owenosborn/CM3-Basic-PCB/README.md

# CM3-Basic-PCB

A basic PCB layout for the Raspberry Pi Compute Module 3 in Eagle.

Uses most of the same parts as the CMIO board.
