owenosborn/CM3-Basic-PCB/cm3_basic.brd

## EAGLE design cm3_basic.brd (2018-09-14)

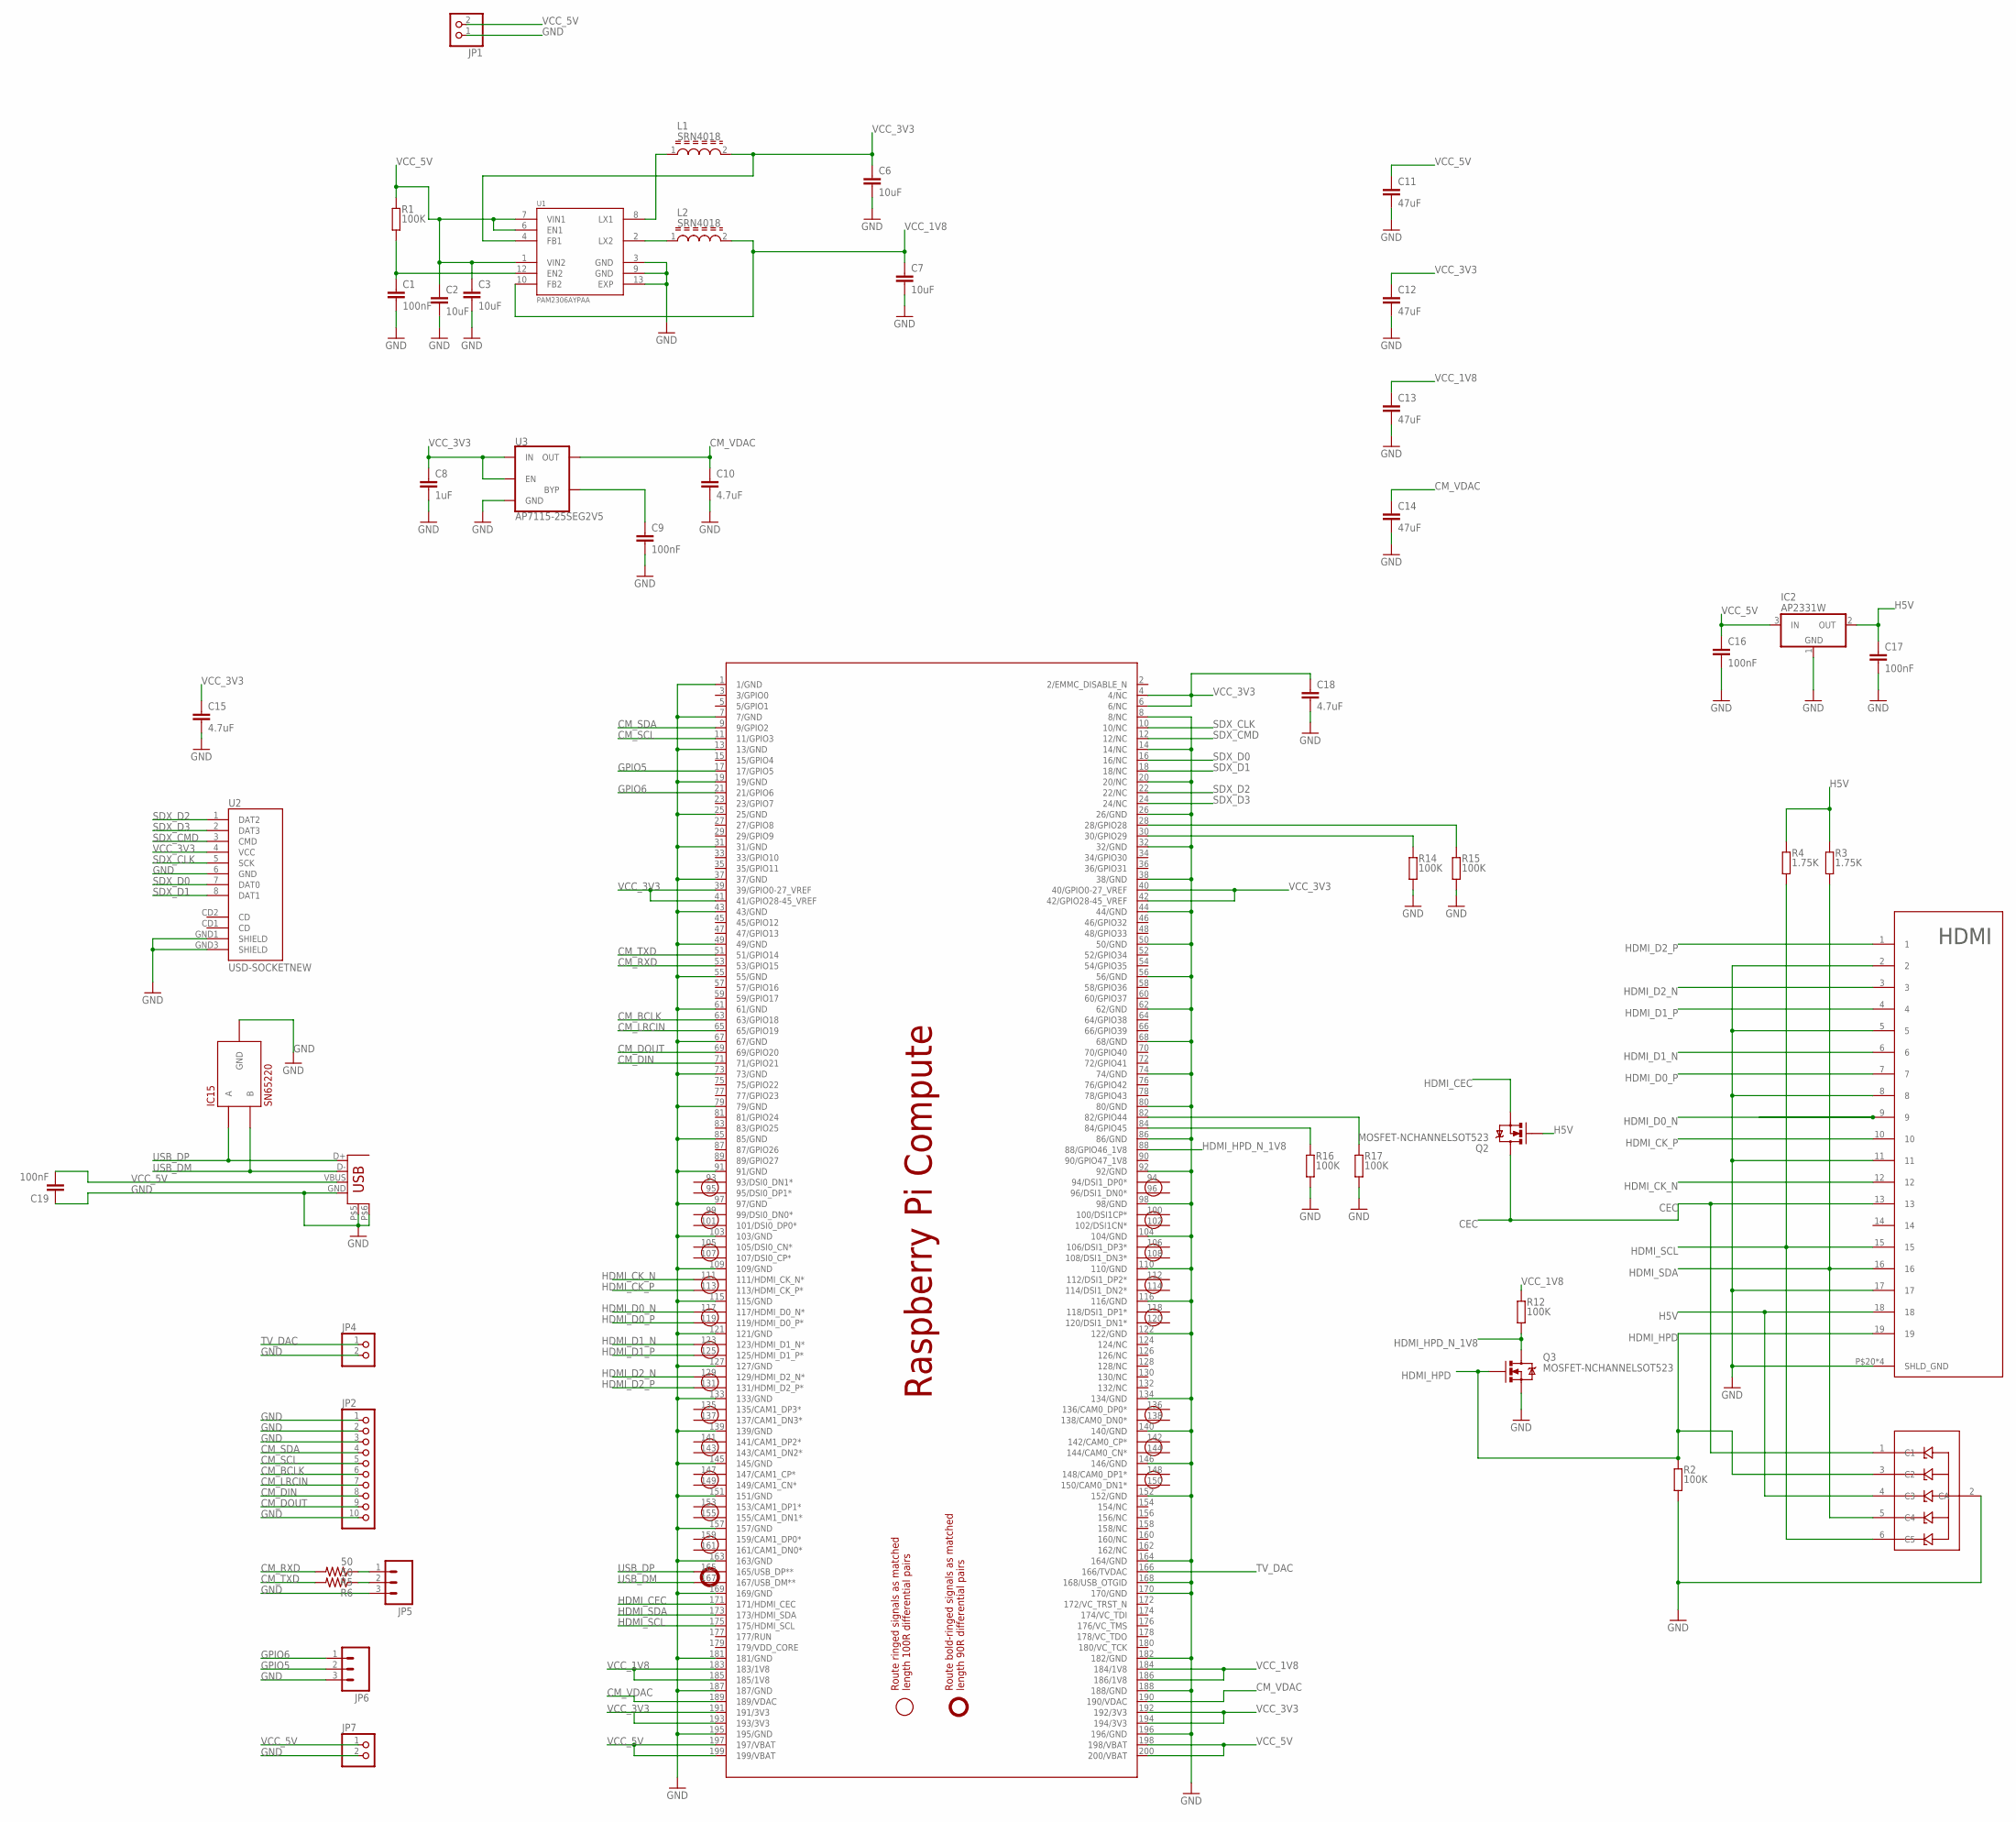
[picture p1: schematic cm3_basic.sch]

Parts:
C1, C9, C16, C17: 100nF; C0603
C2, C3, C6, C7: 10uF; C0805
C8: 1uF; C0603
C10, C15: 4.7uF; C0603
C11, C12, C13, C14: 47uF; C3216
C18: 4.7uF; C1608
C19: 100nF; 0603-CAP
IC1: PESD3V3L5UYSOT363; SOT363-INFINION
IC2: AP2331W; SOT23
IC15: SN65220; SOT23-6L
JP1, JP4, JP7: PINHD-1X2; 1X02
JP2: PINHD-1X10; 1X10
JP3: USB-A; USB-A-S-NOSILK-FEMALE
JP5, JP6: M03LOCK_LONGPADS; 1X03_LOCK_LONGPADS
L1, L2: SRN4018; INDP4040X180N
Q2, Q3: MOSFET-NCHANNELSOT523; SOT523
R1, R2, R12, R14, R15, R16, R17: 100K; R0603
R3, R4: 1.75K; R0603
R5, R6: 50; 0603-RES
SODIMM: RPI_COMPUTE
U1: PAM2306AYPAA; SON45P300X300X80-13N
U2: USD-SOCKETNEW; MICRO-SD-SOCKET-PP
U3: AP7115-25SEG2V5; SC70
U4: HDMI

Connections:
CEC: IC1.1 (C1), Q2.3 (D), U4.13
CM_BCLK: JP2.6, SODIMM.63 (63/GPIO18)
CM_DIN: JP2.8, SODIMM.71 (71/GPIO21)
CM_DOUT: JP2.9, SODIMM.69 (69/GPIO20)
CM_LRCIN: JP2.7, SODIMM.65 (65/GPIO19)
CM_RXD: R5.2, SODIMM.53 (53/GPIO15)
CM_SCL: JP2.5, SODIMM.11 (11/GPIO3)
CM_SDA: JP2.4, SODIMM.9 (9/GPIO2)
CM_TXD: R6.2, SODIMM.51 (51/GPIO14)
CM_VDAC: C10.1, C14.1, SODIMM.189 (189/VDAC), SODIMM.190 (190/VDAC), U3.5 (OUT)
GND: C1.2, C2.2, C3.2, C6.2, C7.2, C8.2, C9.2, C10.2, C11.2, C12.2, C13.2, C14.2, C15.2, C16.2, C17.2, C18.2, C19.1, IC1.2 (CA), IC2.1 (GND), IC15.2 (GND), IC15.5 (GND), JP1.1, JP2.1, JP2.2, JP2.3, JP2.10, JP3.GND, JP3.P$5 (SHIELD1), JP3.P$6 (SHIELD2), JP4.2, JP5.3, JP6.3, JP7.2, Q3.2 (S), R2.1, R14.1, R15.1, R16.1, R17.1, SODIMM.1 (1/GND), SODIMM.7 (7/GND), SODIMM.8 (8/NC), SODIMM.13 (13/GND), SODIMM.14 (14/NC), SODIMM.19 (19/GND), SODIMM.20 (20/NC), SODIMM.25 (25/GND), SODIMM.26 (26/GND), SODIMM.31 (31/GND), SODIMM.32 (32/GND), SODIMM.37 (37/GND), SODIMM.38 (38/GND), SODIMM.43 (43/GND), SODIMM.44 (44/GND), SODIMM.49 (49/GND), SODIMM.50 (50/GND), SODIMM.55 (55/GND), SODIMM.56 (56/GND), SODIMM.61 (61/GND), SODIMM.62 (62/GND), SODIMM.67 (67/GND), SODIMM.68 (68/GND), SODIMM.73 (73/GND), SODIMM.74 (74/GND), SODIMM.79 (79/GND), SODIMM.80 (80/GND), SODIMM.85 (85/GND), SODIMM.86 (86/GND), SODIMM.91 (91/GND), SODIMM.92 (92/GND), SODIMM.97 (97/GND), SODIMM.98 (98/GND), SODIMM.103 (103/GND), SODIMM.104 (104/GND), SODIMM.109 (109/GND), SODIMM.110 (110/GND), SODIMM.115 (115/GND), SODIMM.116 (116/GND), SODIMM.121 (121/GND), SODIMM.122 (122/GND), SODIMM.127 (127/GND), SODIMM.133 (133/GND), SODIMM.134 (134/GND), SODIMM.139 (139/GND), SODIMM.140 (140/GND), SODIMM.145 (145/GND), SODIMM.146 (146/GND), SODIMM.151 (151/GND), SODIMM.152 (152/GND), SODIMM.157 (157/GND), SODIMM.163 (163/GND), SODIMM.164 (164/GND), SODIMM.168 (168/USB_OTGID), SODIMM.169 (169/GND), SODIMM.170 (170/GND), SODIMM.181 (181/GND), SODIMM.182 (182/GND), SODIMM.187 (187/GND), SODIMM.188 (188/GND), SODIMM.195 (195/GND), SODIMM.196 (196/GND), U1.3 (GND), U1.9 (GND), U1.13 (EXP), U2.6 (GND), U2.GND1 (SHIELD), U2.GND3 (SHIELD), U3.2 (GND), U4.2, U4.5, U4.8, U4.11, U4.17, U4.P$20 (SHLD_GND), U4.P$21 (SHLD_GND), U4.P$22 (SHLD_GND), U4.P$23 (SHLD_GND)
GPIO5: JP6.2, SODIMM.17 (17/GPIO5)
GPIO6: JP6.1, SODIMM.21 (21/GPIO6)
H5V: C17.1, IC1.4 (C3), IC2.2 (OUT), Q2.1 (G), R3.2, R4.2, U4.18
HDMI_CEC: Q2.2 (S), SODIMM.171 (171/HDMI_CEC)
HDMI_CK_N: SODIMM.111 (111/HDMI_CK_N*), U4.12
HDMI_CK_P: SODIMM.113 (113/HDMI_CK_P*), U4.10
HDMI_D0_N: SODIMM.117 (117/HDMI_D0_N*), U4.9
HDMI_D0_P: SODIMM.119 (119/HDMI_D0_P*), U4.7
HDMI_D1_N: SODIMM.123 (123/HDMI_D1_N*), U4.6
HDMI_D1_P: SODIMM.125 (125/HDMI_D1_P*), U4.4
HDMI_D2_N: SODIMM.129 (129/HDMI_D2_N*), U4.3
HDMI_D2_P: SODIMM.131 (131/HDMI_D2_P*), U4.1
HDMI_HPD: IC1.3 (C2), Q3.1 (G), R2.2, U4.19
HDMI_HPD_N_1V8: Q3.3 (D), R12.1, SODIMM.88 (88/GPIO46_1V8)
HDMI_SCL: IC1.6 (C5), R4.1, SODIMM.175 (175/HDMI_SCL), U4.15
HDMI_SDA: IC1.5 (C4), R3.1, SODIMM.173 (173/HDMI_SDA), U4.16
unnamed: L1.1, U1.8 (LX1)
unnamed: C1.1, R1.1, U1.12 (EN2)
unnamed: JP5.1, R5.1
unnamed: JP5.2, R6.1
unnamed: L2.1, U1.2 (LX2)
unnamed: C9.1, U3.4 (BYP)
unnamed: R16.2, SODIMM.84 (84/GPIO45)
unnamed: R15.2, SODIMM.28 (28/GPIO28)
unnamed: R14.2, SODIMM.30 (30/GPIO29)
unnamed: R17.2, SODIMM.82 (82/GPIO44)
SDX_CLK: SODIMM.10 (10/NC), U2.5 (SCK)
SDX_CMD: SODIMM.12 (12/NC), U2.3 (CMD)
SDX_D0: SODIMM.16 (16/NC), U2.7 (DAT0)
SDX_D1: SODIMM.18 (18/NC), U2.8 (DAT1)
SDX_D2: SODIMM.22 (22/NC), U2.1 (DAT2)
SDX_D3: SODIMM.24 (24/NC), U2.2 (DAT3)
TV_DAC: JP4.1, SODIMM.166 (166/TVDAC)
USB_DM: IC15.4 (B), JP3.D-, SODIMM.167 (167/USB_DM**)
USB_DP: IC15.6 (A), JP3.D+, SODIMM.165 (165/USB_DP**)
VCC_1V8: C7.1, C13.1, L2.2, R12.2, SODIMM.183 (183/1V8), SODIMM.184 (184/1V8), SODIMM.185 (185/1V8), SODIMM.186 (186/1V8), U1.10 (FB2)
VCC_3V3: C6.1, C8.1, C12.1, C15.1, C18.1, L1.2, SODIMM.4 (4/NC), SODIMM.6 (6/NC), SODIMM.39 (39/GPIO0-27_VREF), SODIMM.40 (40/GPIO0-27_VREF), SODIMM.41 (41/GPIO28-45_VREF), SODIMM.42 (42/GPIO28-45_VREF), SODIMM.191 (191/3V3), SODIMM.192 (192/3V3), SODIMM.193 (193/3V3), SODIMM.194 (194/3V3), U1.4 (FB1), U2.4 (VCC), U3.1 (IN), U3.3 (EN)
VCC_5V: C2.1, C3.1, C11.1, C16.1, C19.2, IC2.3 (IN), JP1.2, JP3.VBUS, JP7.1, R1.2, SODIMM.197 (197/VBAT), SODIMM.198 (198/VBAT), SODIMM.199 (199/VBAT), SODIMM.200 (200/VBAT), U1.1 (VIN2), U1.6 (EN1), U1.7 (VIN1)

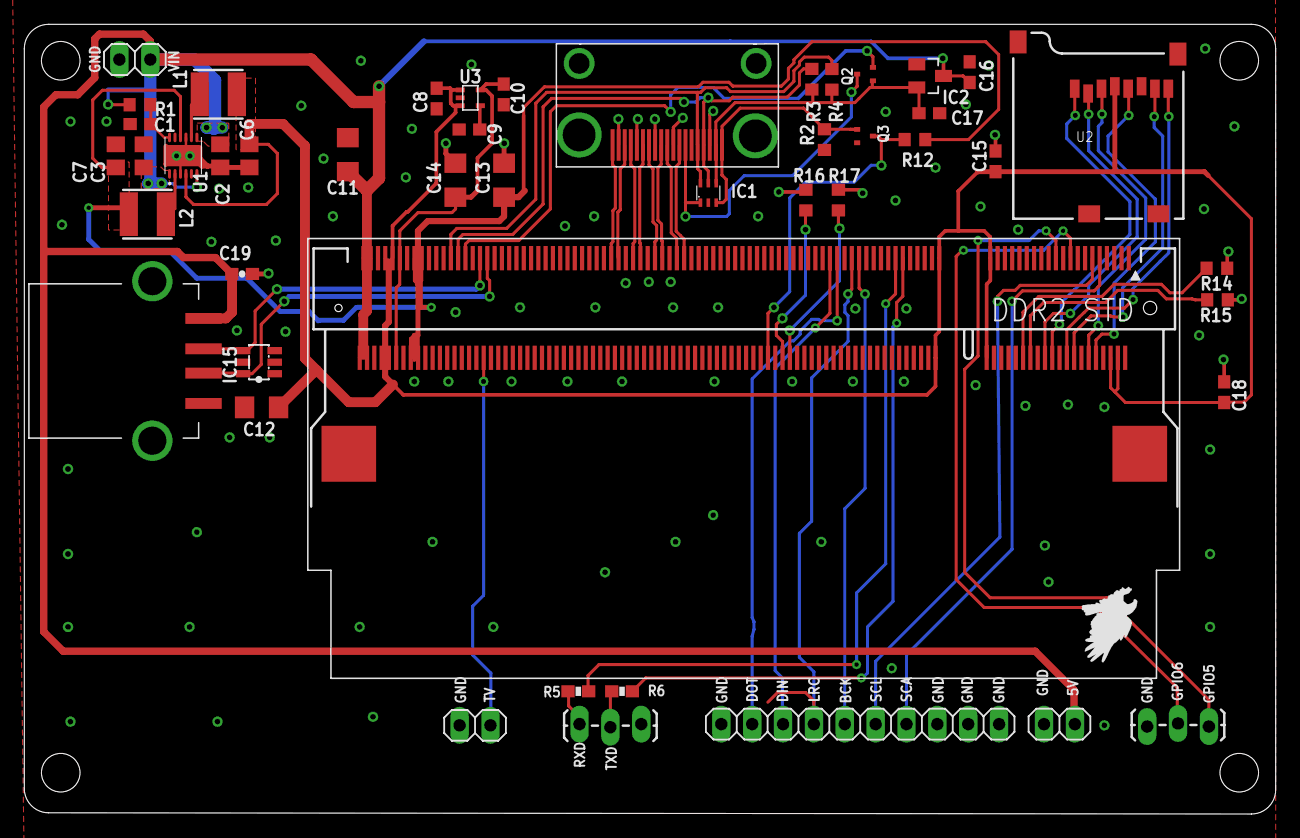
[picture p2: board cm3_basic.brd from above]

Board: 2 copper layers, 103.0 x 65.0 mm, 47 parts (0 on the bottom side), 49 nets.
