owenosborn/CM3-Basic-PCB/(threads)

Thread 1 (2020-02-14):

Wifi

mrsstaceyseigle, 2020-02-14:
Do this board includes wifi.

WaskaLabs, 2020-02-14:
No. You'd need an external wifi chip

mrsstaceyseigle, 2020-02-14:
Few questions:
1. Does this board have Ethernet.
2. Can you give me the outer dimensions of this board (width, length and if you know the height of the highest component)

Also if it is not asking for to much is there any way that you can edit this board to include wifi adapter and Ethernet port if one does not already exist. Also is there any way to make the board width smaller like around 50mm wide

Closed 2020-02-26.

Thread 2 (2020-02-17):

gpio pins

mrsstaceyseigle, 2020-02-17:
I notice this board only has 10 gpio pins. Can you tell me which pins are included. Also will I2C displays works with this

willyhsu0819, 2020-07-20:
Hi mrsstaceyseigle, pin header JP2 is include SDA & SCL

willyhsu0819, 2020-07-20:
> I notice this board only has 10 gpio pins. Can you tell me which pins are included. Also will I2C displays works with this

Hi mrsstaceyseigle, pin header JP2 is include SDA & SCL
