owenosborn/CM3-Basic-PCB/(commit log)

2018-09-14 adding pcb
    [cm3_basic.brd, cm3_basic.sch]
2018-09-14 added BOM
    [BOM.csv]
2018-09-25 clean up
    [cm3_basic.brd, cm3_basic.sch]
2018-09-25 adding pcb files
    [cm3_basic.brd, cm3_basic.sch]
2018-09-25 adding bom
    [BOM.csv]
